claudiusmarius/THE-BIG-CAPACITOR-DISCHARGER-DFTA253/ListeComposantsDFTA253.xlsx

Sheet: Feuil1
REF | VALEUR | UNITE | OBS1 | OBS2
C1
C2 | 100 | nF | SMD 1206
C3 | 100 | nF | SMD 1206
C6 | 100 | nF | SMD 1206
C7 | 100 | nF | SMD 1206
R1 | 39 | K
R2 | 39 | K
R3 | 39 | K
R4 | 39 | K
R5 | 39 | K
R6 | 39 | K
R7 | 39 | K
R8 | 39 | K
R9 | 3.3 | K
R10 | 3.3 | K
R11 | 3.3 | K
R12 | 3.3 | K
R13 | 5.6 | K
R14 | 220 | Ω
R15 | 220 | Ω
R16 | 820 | Ω
R17 | 56 | K
R18 | 56 | K
J1 | Bornier à vis DERKS YEO |  | 5.08 2 bornes
J2 | Bornier à vis DERKS YEO |  | 5.08 2 bornes
J3 | Bornier à vis DERKS YEO |  | 5.08 2 bornes
J4 | Pinheader |  | 2.54 3 broches + cavalier
J5 | Connector_JST:JST_EH_B3B-EH-A_1x03_P2.50mm_Vertical |  | Par exemple 1005007080333485 chez aliexpress (Straight pin socket)
J6 | Connector_JST:JST_EH_B3B-EH-A_1x03_P2.50mm_Vertical |  | Par exemple 1005007080333485 chez aliexpress (Straight pin socket)
J7 | Bornier à vis DERKS YEO |  | 5.08 2 bornes
J8 | Bornier à vis DERKS YEO |  | 5.08 2 bornes
J9 | Bornier à vis DERKS YEO |  | 5.08 2 bornes
J10 | Pinheader |  | 2.54 3 broches + cavalier
BZ1 |  |  | 3,3V
D1 | LED
D2 | LED
D3 | LED
D4 | LED
D5 | 1N5817 |  | Diode Schottky
D6 | LED
U1 | SEEEDUINO XIAO |  | Et ses deux pinheader femelles 7 broches
U2 | R-78E5.0_0.5 |  | Régulateur 5V Recom 500mA
U3 | SN74AHCT125SN |  | Et sa socket DIP14
U4 | TC4427 |  | Et sa socket DIP8
U5 | TC4427 |  | Et sa socket DIP8
U6
 |  |  | Par exemple 1005006149754236 chez aliexpress, bien choisir la hauteur selon le besoin
 |  |  | Par exemple 1005007655828920 chez aliexpress
 | Cordon JST femelle femelle 3 pinoches |  | Par exemple 1005002694888803. chez Aliexpress bien choisir la longueur souhaitée | Pour J1 et J2

Sheet: Feuil2
1228229 | 7773291
1228230 | 9176626
1228231 | 1228231
 | 1228230
 | 1228229
 | 1446290
 | 7577239
