claudiusmarius/THE-BIG-CAPACITOR-DISCHARGER-DFTA253/Schematic_DFTA244_2026-04-30.pdf

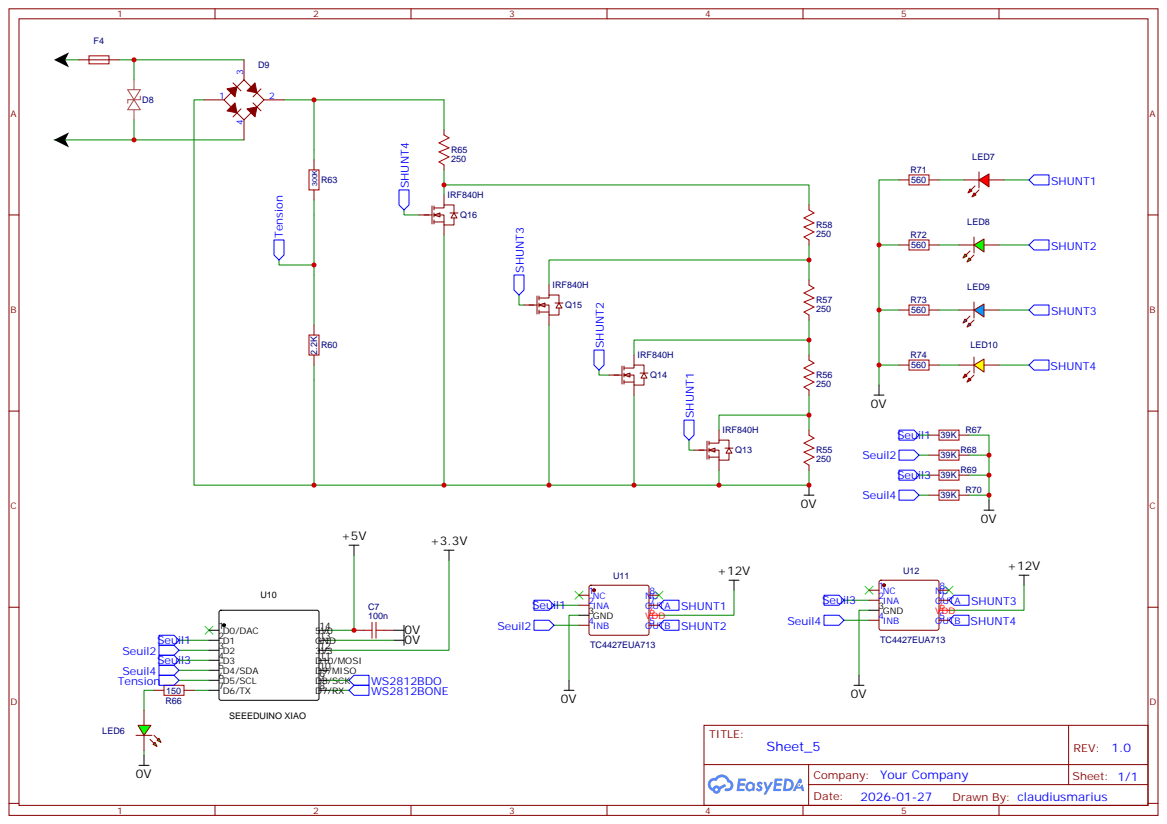
[picture p1: page 1]
